crobison/string-art/machine/wiring/guide.html

String art platter machine · wiring

# Set up, test, then wire

Sections A–C set the PiBot V4.96 Pro's jumpers, load the FluidNC config and spin one motor on the bench. Steps 1–5 then show the real parts on a workbench mat with every wire drawn in the colour you will use. Tick each wire off as you go. Your ticks stay in this browser. Hover or tap a wire in the list to light it up in the drawing.

### Before you start

- Tools: small flat screwdriver, wire stripper, multimeter with a continuity beeper, ferrule crimper, soldering iron (step 5 only).
- Wire: 18 AWG red and black for power, 22 AWG for signals. Ferrules to suit both.
- Two Wago 221-415 lever nuts. One is the +24 V bus, one is the GND bus.
- Three JST-XH 2.54 mm 3-pin plugs (or a crimp kit) for the endstop cables. The limit inputs are sockets, not screw terminals.
- A barrel-jack-to-screw adapter rated 10 A that matches the brick's tip. Many are rated 3–5 A. Or cut the brick's plug off and put its leads straight into the lever nuts.

#### Four rules

1. The power brick stays unplugged from the wall while you wire.
2. Never plug or unplug a motor while the power is on. It destroys the driver.
3. Red is always +, black is always GND. Check with the meter before the first power-up.
4. The brick is set to 24.0 V and never higher. The board's main input is rated 9–24 V.

### Reading the drawings

An orange dashed box marks the terminals you touch in that step. The PiBot drawing is simplified, but every connector is on the correct edge of the board. Several of the board's terminals have no pin labels. Where that matters, the step says how to find each pin with the meter.

A

## Board setup: jumpers

Set the PiBot's jumpers for this machine before anything is connected. The circled numbers match PiBot's V4.96 Pro pin definition overview (https://wiki.pibot.com/doku.php?id=pibot_cnc_laser_series:v496_pro:v49pro_diagram_overview:start), so you can find each one on their board photo.

#### Do first

1. Board unpowered, USB unplugged, nothing on any terminal.
2. Screw on the Wi-Fi antenna. Without it there is no Wi-Fi. Plug in the OLED. A TF card is optional.
3. Use tweezers or pliers for the jumpers (the small plastic caps that bridge two pins). Fit or remove each one, then check it against the table again.
4. Most jumper headers here have 3 pins: the jumper joins the middle pin to one side, so the side matters. The table says which.

#### Careful

1. Each of the six driver slots has a StepStick socket: two rows of 8 female header pins that a plug-in driver board pushes into. Your TMC2209s are StepSticks, and they go in the sockets of slots 2 and 3.
2. Slot 1 (X on the silkscreen) is different. The DM542T is an external driver and doesn't plug in. Fit all four of slot 1's routing jumpers (header H4, beside the socket), and leave slot 1's socket empty.
3. Never put a TMC2209 in slot 1. With the routing jumpers in, its 24 V motor outputs land on the board's logic lines. That destroys the driver and the board's chips.
4. The board ships with only three jumpers fitted (VDD, SW-VCC, RLY). Every other jumper in this table is one you add.

# | Jumper | Factory | Set to | Why

⑳ | USB 5V | not fitted | None | Feeds USB 5 V into the board for bench use only. PiBot says it must be off whenever the 24 V supply is connected.
⑫ | VDD, labelled "Driver Logic Signal level" (VDDSEL1) | 3V3 | +5V side | The DM542T's inputs need 5 V signals. TMC2209s run on anything from 3.3 to 5 V, and VDD also sets the high level for MS1/MS2.
⑦ | SW-VCC (SWVSEL1), limit inputs | +5V | +5V (leave) | Correct for plain mechanical switches. The VMOT side is only for 12–24 V NPN sensors.
⑬ | RLY (GPIO26 function), in the header marked SLP RST NULL MS2 MS1 RLY | Relay | Relay (leave) | Lets gpio26 drive the on-board relay that switches the drill (step 5). Note which side it is on: MS1 and MS2 go on the same side.
⑯ ⑰ | Slot 1 routing jumpers (H4), 4 of them | none | All 4 fitted | Sends slot 1's EN, STP, DIR and GND out to its green terminal for the DM542T. This is PiBot's "external standard driver" mode.
⑯ ⑰ | Slot routing jumpers, slots 2–6 | none | None | Slots 2 (Y) and 3 (Z) hold the TMC2209s, which drive their green terminals directly.
⑭ | MS1 and MS2 (one pair shared by all six sockets) | none | Both fitted, same side as RLY | That side is VDD, so MS1 = MS2 = high: the TMC2209's 1/16 microstepping (3200 steps/turn), which the config assumes. On the other side they pull low and the drivers run at 1/8.
⑭ | NULL, RST, SLP | none | None | NULL (the MS3 position) isn't connected on this board. RST and SLP are only for A4988/DRV8825 drivers. An SLP jumper to VDD would hold the TMC2209s' CLK pin high.
⑲ | SPI jumpers | none | None | Only for SPI-mode drivers (TMC2130, TMC5160). Ours run standalone on step/dir.

#### Check before moving on

1. Count the jumpers: 9 on the board in total, whatever the board shipped with. VDD on +5V (1), SW-VCC on +5V (1), RLY on relay (1), slot 1 routing (4), MS1 and MS2 on the same side as RLY (2). Nothing on USB-5V, NULL, RST, SLP, SPI or slots 2–6.
2. If your count isn't 9, compare each row of the table above with the board until it is. Spare jumpers go in a bag, not on unused pins.
3. Optional meter check once the board has 24 V (section B): socket 2's MS1 and MS2 pins read about 5 V to GND. The bench test in section C proves this anyway.

B

## Firmware and config

The board ships with FluidNC 3.9.9 already flashed and a factory test config. You don't need to flash anything. You only upload our two config files.

#### Power the bare board

1. The power inputs are the orange connectors on the board's bottom edge, labelled underneath: Vmot-Driver, Vmot, then MOSFET and RELAY.
2. Wire only the first two pairs of step 1: brick → lever nuts → Vmot (+ and − are printed under it). Vmot is a plug: pull it straight off, wire it, push it back on. Nothing else connected yet.
3. Plug in the brick. The 5 V LED lights and the OLED shows FluidNC.
4. Meter across Vmot-Driver: about 0 V. It's a separate input that only feeds the driver sockets.

#### Not a power input

1. The black 5-pin header near the ESP32 is labelled GP27, GP25, +5V, VMOT Main, GND. It's an output for add-on modules. Never connect the brick there.

#### Open the web interface

1. On a laptop or phone, join Wi-Fi FluidNC, password 12345678.
2. Browse to http://192.168.0.1. That opens FluidNC's WebUI.
3. Optional: PiBot's own 60-minute factory checklist (https://wiki.pibot.com/doku.php?id=pibot_cnc_laser_series:v496_pro:check_list_before_use:start) tests every input and output with the factory config. Run it now if you want a known-good board before you start.

#### Upload our configs

1. From the repo, copy machine/fluidnc-bench.yaml as bench.yaml and machine/fluidnc-config.yaml as stringart.yaml.
2. Upload both to the board's flash, not the SD card: FluidNC only reads its config from flash. The Files panel on the WebUI dashboard shows only the SD card. The flash is under the FluidNC tab at the top of the WebUI: press Manage local files and upload there. Leave the factory config.yaml there as a fallback.
3. In the WebUI console, send these one line at a time:

$Config/Filename=bench.yaml
$Bye                       (restarts the board)
$SS                        (startup log: look for errors)
$CD                        (prints the config it actually loaded)

The startup log should have no [MSG:ERR: lines. $CD should show name: StringArtBench. A config problem leaves the board in alarm, and $X then answers "Configuration is invalid". To go back to the factory test config, send $Config/Filename=config.yaml and $Bye.

#### Only if you ever need to re-flash

1. Use Chrome or Edge, which can open serial ports from a web page. Go to installer.fluidnc.com, plug in USB and pick the port.
2. Choose Install FluidNC, then pick release v3.9.9 to match the factory firmware (the newest 4.x also accepts our configs). Then processor esp32 if asked, firmware variant wifi, installation type fresh-install. In the confirm box, under Extra Options, tick Install WebUI-2, then Install.
3. If it reports "Bootloader not active", hold the board's BOOT button while it connects.
4. Linux: the board's CP2102 USB chip needs no driver, but your user must be in the dialout group (uucp on Arch): sudo usermod -aG dialout $USER, then log out and back in.
5. A fresh install wipes the flash, so upload both YAML files again afterwards.

C

## Bench test: one motor

Before the full wiring, prove one driver, one motor and the config on the bench. Each test command turns the motor shaft exactly once, so it checks the microstep setting as well as the wiring. Uses bench.yaml, which has no homing, so you can jog straight away.

#### Test 0: signal LEDs, no motor

1. Power goes only to the orange plug-in connector labelled Vmot (CN3). Leave the Vmot-Driver screw terminal unconnected, the driver sockets empty and every motor unplugged.
2. Check that the board is running bench.yaml: send $SS. The log should show Configuration file:bench.yaml and no [MSG:ERR: line. If it names a different file, send $Config/Filename=bench.yaml, then $Bye.
3. Find the signal LEDs: each slot has a column of three small LEDs just right of its socket, labelled by the I2S output that drives them, not by name. Slot 1: I2.0 = EN, I2.2 = STEP, I2.1 = DIR. Slot 2: I2.7 = EN, I2.5 = STEP, I2.4 = DIR. Slot 3: I2.8 = EN, I2.10 = STEP, I2.9 = DIR.
4. The EN LEDs (I2.0, I2.7, I2.8) should be off. A lit EN LED means that driver is switched off; off means the config is holding it on.
5. Send $J=G91 X10 F300, then $J=G91 X-10 F300. Slot 1's DIR LED (I2.1) changes state between the two: on for one direction, off for the other. The STEP LED (I2.2) may glow faintly or not visibly at all: the pulses are only 4 µs long. The DIR LED is the reliable check.
6. Repeat with $J=G91 Y10 F600 and $J=G91 Y-10 F600: slot 2's DIR LED (I2.4) changes state. This is PiBot's test 2.8.

#### Test 1: arm motor (small NEMA17) on a TMC2209

1. This test uses one of your two small, thin NEMA17 motors (17HE08-1004S, 1 A). This one will drive the threader arm (Y). It is not the platter: the platter's motor is the big NEMA23, tested in Test 2. Nothing needs to be built yet. The motor just sits on the bench.
2. Brick unplugged. Add the second power pair from step 1: brick + and − to the orange Vmot-Driver screw terminal. This one feeds the driver sockets, and Vmot keeps feeding the board.
3. Plug a TMC2209 into socket 2, the socket next to the I2.7, I2.5 and I2.4 LEDs. Its EN pin goes to the socket's EN mark (step 3's drawing). No motor yet.
4. Power on. Set the TMC2209's current: measure Vref and turn its pot until it reads 0.9–1.0 V (step 3 shows where). It reads 0 V until Vmot-Driver has 24 V.
5. Brick unplugged again. Find the motor's two coils with the meter: black–blue is one, green–red the other, about 3.6 Ω each. Connect it to slot 2's green terminal as in step 3: black and blue on the two screws at one end, green and red on the two at the other. Stick a tape flag on the shaft so you can count turns.
6. Power on. Send $J=G91 Y40 F600: the shaft turns exactly once in about 4 s. Send $J=G91 Y-40 F600: it turns back.

#### Test 2: platter NEMA23 on the DM542T

1. Brick unplugged. Wire step 1's DM542T pair and all of step 2, with the DIP switches set and the DM542T's 5V/24V selector (if it has one) on 5V.
2. Power on. The DM542T's green LED lights, and the red one stays off.
3. Send $J=G91 X72 F600: the NEMA23 shaft turns exactly once in about 7.5 s. (72 nails × 44.444 = 3200 steps.) $J=G91 X-72 F600 brings it back.
4. With the belt and platter fitted, upload and run machine/platter-test.gcode (about 6 min). It runs half turns at rising speeds, full-speed turns and a threading pattern, and stops for 5 s after each part so you can check that a mark on the rim still lines up with a fixed pointer. If it drifts or sounds rough, lower max_rate_mm_per_min or acceleration_mm_per_sec2 on X.

You see | Cause | Fix
Exactly one turn | Everything is right | Move on
Small NEMA17 turns twice | TMC2209 at 1/8: MS1/MS2 jumpers missing or on the wrong side | Both on the same side as RLY (section A)
Small NEMA17 turns ½ or ¼ turn | TMC2209 at 1/32 or 1/64: only one MS jumper is high | Put MS1 and MS2 on the same side as RLY, and re-seat both
NEMA23 turns half a turn | DM542T at 6400 | SW5–8 = ON ON OFF ON
NEMA23 turns twice | DM542T at 1600 (SW5–8 = OFF OFF ON ON) | SW5–8 = ON ON OFF ON
Motor buzzes or jitters but doesn't turn | The two wires of one coil are split across the two coil pairs | Power off. Find the pairs with the meter (small NEMA17 about 3.6 Ω, NEMA23 about 1 Ω between the two wires of a coil) and put each coil on its own pair of screws
Silent, shaft turns freely by hand | No motor power, driver disabled, or no signal reaching it | TMC2209: is 24 V on Vmot-Driver? Is Vref above 0? DM542T: is the green LED on, and is the 5V/24V selector on 5V?
Silent, and the slot's DIR LED doesn't change between + and − jogs | Config problem, or the controller is in alarm | Send $X, then check $SS for [MSG:ERR: lines
DM542T red LED blinks | 1 blink: over-current or a short in the motor wiring. 2 blinks: over-voltage | Power off and check the motor leads and the brick's voltage
Turns the wrong way | Normal: direction is arbitrary until set | Fix it later, after assembly: add :low to that axis's direction_pin

#### When both motors pass

1. Power off and finish wiring with steps 1–5 below.
2. Then switch to the real config: $Config/Filename=stringart.yaml and $Bye. It expects homing, so it starts locked. $H homes once the endstops are in. $X unlocks without homing, but then nail 0 is wherever the platter happens to be.

✓

## First full power-up

Everything is wired. Go through this once before plugging the brick into the wall.

#### Checklist

1. Every motor is plugged in, and stays plugged in while the power is on.
2. No loose copper strands at any screw terminal. Tug every wire.
3. Meter: 24 V on the lever nuts, not more.
4. Jumpers still match section A (9 in total). Slot 1's socket is empty.
5. Both TMC2209s point the right way, Vref set to 0.9–1.0 V.
6. $Config/Filename=stringart.yaml, $Bye, then $SS shows no [MSG:ERR: lines.
7. Send ?. There is no Pn: entry with every switch at rest.
8. Home with $H: Y and Z home first, then X finds nail 0. Keep a hand on the wall plug the first time.
9. Drill test with the bit out: M3 S1000 spins it after the 2 s spin-up wait, M5 stops it. If the board resets when the drill starts, see step 5.

Generated by machine/wiring/make_harness.py from the same wire list as the KiCad schematic (wiring.kicad_sch) and the WireViz diagrams (harness/). Every wire here is checked against the schematic's netlist when the page is built.

Pins, jumpers and the flashing steps follow PiBot's V4.96 Pro wiki (https://wiki.pibot.com/doku.php?id=pibot_cnc_laser_series:v496_pro:introduction:start) and its factory test YAML and schematic, checked 2026-11-05. The config is machine/fluidnc-config.yaml, and the bench config is machine/fluidnc-bench.yaml.
