crobison/string-art/machine/wiring/harness/03_arm_drill_motors.html

# Step 3: threader (Y) and drill-feed (Z) motors

## Diagram

## Bill of Materials

Id | Description | Qty | Unit | Designators
1 | Connector, NEMA17 17HE08-1004S (small, thin), drill feed motor (Z), 4 pins | 1
2 | Connector, NEMA17 17HE08-1004S (small, thin), threader motor (Y), 4 pins | 1
3 | Connector, PiBot V4.96 Pro, slot 2 green terminal (Y, TMC2209 fitted), 4 pins | 1
4 | Connector, PiBot V4.96 Pro, slot 3 green terminal (Z, TMC2209 fitted), 4 pins | 1
5 | Wire, 22 AWG, black | 0 | m | Y motor cable, Z motor cable
6 | Wire, 22 AWG, blue | 0 | m | Y motor cable, Z motor cable
7 | Wire, 22 AWG, green | 0 | m | Y motor cable, Z motor cable
8 | Wire, 22 AWG, red | 0 | m | Y motor cable, Z motor cable
