crobison/string-art/machine/wiring/harness/01_power.html

# Step 1: 24 V power distribution

## Diagram

## Bill of Materials

Id | Description | Qty | Unit | Designators
1 | Connector, 24 V power brick, barrel adapter rated 10 A, or bare leads, 2 pins | 1
2 | Connector, DM542T, power + motor terminal, 6 pins | 1
3 | Connector, PiBot V4.96 Pro, orange power inputs, bottom edge, 4 pins | 1
4 | Connector, Wago 221-415 lever nut, +24 V bus (5-way), 5 pins | 1
5 | Connector, Wago 221-415 lever nut, GND bus (5-way), 5 pins | 1
6 | Wire, 18 AWG, black | 0 | m | DM542T power, PSU leads, PiBot Vmot, PiBot Vmot-Driver
7 | Wire, 18 AWG, red | 0 | m | DM542T power, PSU leads, PiBot Vmot, PiBot Vmot-Driver
