crobison/string-art/machine/wiring/harness/02_platter.html

# Step 2: platter motor (X) on the DM542T

## Diagram

## Bill of Materials

Id | Description | Qty | Unit | Designators
1 | Connector, DM542T, power + motor terminal, 6 pins | 1
2 | Connector, DM542T, signal terminal, 6 pins | 1
3 | Connector, NEMA23 23HS45-4204S, platter motor (X), 4 flying leads, 4 pins | 1
4 | Connector, PiBot V4.96 Pro, slot 1 green terminal (X, routing jumpers in), 4 pins | 1
5 | Wire, 18 AWG, black | 0 | m | NEMA23 leads (18 AWG)
6 | Wire, 18 AWG, blue | 0 | m | NEMA23 leads (18 AWG)
7 | Wire, 18 AWG, green | 0 | m | NEMA23 leads (18 AWG)
8 | Wire, 18 AWG, red | 0 | m | NEMA23 leads (18 AWG)
9 | Wire, 22 AWG, black | 0 | m | X step/dir
10 | Wire, 22 AWG, white | 0 | m | X step/dir
11 | Wire, 22 AWG, yellow | 0 | m | X step/dir
