crobison/string-art/machine/wiring/harness/04_endstops.html

# Step 4: endstops (wired normally-closed)

## Diagram

## Bill of Materials

Id | Description | Qty | Unit | Designators
1 | Connector, Endstop switch, X index: fires at nail 0, 3 pins | 1
2 | Connector, Endstop switch, Y home: tip outside the ring, 3 pins | 1
3 | Connector, Endstop switch, Z home: drill fully up, 3 pins | 1
4 | Connector, PiBot V4.96 Pro, X limit input io33 (3-pin JST-XH), 3 pins | 1
5 | Connector, PiBot V4.96 Pro, Y limit input io32 (3-pin JST-XH), 3 pins | 1
6 | Connector, PiBot V4.96 Pro, Z limit input io35 (3-pin JST-XH), 3 pins | 1
7 | Wire, 22 AWG, black | 0 | m | X endstop, Y endstop, Z endstop
8 | Wire, 22 AWG, white | 0 | m | X endstop, Y endstop, Z endstop
