crobison/string-art/machine/wiring/harness/05_drill_relay.html

# Step 5: drill on the on-board relay

## Diagram

## Bill of Materials

Id | Description | Qty | Unit | Designators
1 | Connector, 1N5822 diode, flyback, solder across the drill tabs, 2 pins | 1
2 | Connector, 555 drill motor, 24 V, solder tabs, 2 pins | 1
3 | Connector, PiBot V4.96 Pro, on-board relay terminal (gpio26), 3 pins | 1
4 | Connector, Wago 221-415 lever nut, +24 V bus (5-way), 5 pins | 1
5 | Connector, Wago 221-415 lever nut, GND bus (5-way), 5 pins | 1
6 | Wire, 18 AWG, black | 0 | m | Drill 24 V (18 AWG)
7 | Wire, 18 AWG, red | 0 | m | Drill 24 V (18 AWG)
8 | Wire, 22 AWG, silver | 0 | m | Diode legs
