crobison/string-art/machine/wiring/wiring.pdf

1 | 2 | 3 | 4 | 5 | 6 | 7 | 8
1 | 2 | 3 | 4 | 5 | 6 | 7 | 8

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
Size: A3 | Rev: 2 | F Date: 2026-11-04
KiCad E.D.A. 10.0.8 | Id: 1/1

## Title: String art machine wiring

File: wiring.kicad_sch

Sheet: /

crobison/string-art

Generated by machine/wiring/make_schematic.py

Pins mirror machine/fluidnc-config.yaml

M

A+/blk
A-/blu
B+/grn

B-/red M2

17HE08-1004S threader (Y)

PUL+
PUL-DIR+
DIR-ENA+
ENA-

VDC
GND

A+
A-B+
B-
U2 CN3 Vmot (main) | DM542T, DIP 1-8: OFF ON OFF OFF ON ON OFF ON
CN4 Vmot-Driver Limit inputs, JST-XH (SW-VCC 5V) CN1 relay (gpio26) | TBX1 slot 1 (jumpers in) Socket 2 (Y) signals Socket 3 (Z) signals Driver logic (VDD jumper 5V) VMAIN+

VMAIN-

VDRV+
VDRV-

X_LIM/gpio33
Y_LIM/gpio32
Z_LIM/gpio35
LIM_GND
SW_VCC

RLY_COM
RLY_NC
RLY_NO

EN/I2SO.0
STP/I2SO.2
DIR/I2SO.1
S1_GND

STEP/I2SO.5
DIR/I2SO.4
EN/I2SO.7

STEP/I2SO.10
DIR/I2SO.9
EN/I2SO.8
VDD MS1 MS2 U1 PiBot V4.96 Pro (ESP32, FluidNC) | M

A+/blk
A-/grn
B+/red

B-/blu M1

23HS45-4204S platter (X)

COM
NCNO

SW3

Z home (drill up) | STEP DIR ENMS1 MS2

VIO
GND

VM
GND

1A 1B

2A 2B U4

TMC2209 in socket 3 (Z), Vref 0.9-1.0 V COM

NCNO

SW2

Y home (tip outside) COM
NCNO

SW1

X index (nail 0) | M

A+/blk
A-/blu
B+/grn

B-/red M3

17HE08-1004S drill Z

+24V GND

J1

24 V 6 A brick + barrel-to-screw adapter | K

AD1

1N5822 flyback (recommended) | STEP DIR ENMS1 MS2

VIO
GND

VM
GND

1A 1B

2A 2B U3

TMC2209 in socket 2 (Y), Vref 0.9-1.0 V + M -

M4

555 drill motor (24 V) | X_A+

X_B-

X_A-

Y_B2

X_B+
X_B-

+24V GND

Y_B1

Z_STEP
Z_DIR
Z_EN
VDD

VDD

X_B+

X_A-

X_A+

+24V | GND X_DIR GND

X_STEP

Y_EN

Y_DIR

Y_STEP

GND

X_DIR

X_STEP

Z_B2 GND +24V

Y_B2

Y_B1

Y_A2

Y_A1 GND

VDD

VDD

VDD

Y_EN

Y_DIR

Y_STEP

VDD
Z_B1

Z_A2

Z_A1

Z_B2

Z_B1

Z_A2

Y_A1

Z_A1

Y_A2 GND +24V GND

+24V DRILL+

DRILL+
GND

Z_STEP

GND

Y_LIM

X_LIM

# GND +24V Z_LIM

GND

DRILL+

+24V GND

X_LIM

Z_LIM

GND

GND
Y_LIM

GND

VDD

GND

Z_DIR

VDD

VDD

Z_EN NOTES

1. Pins follow the PiBot V4.96 Pro factory YAML and schematic (sch496, 2025-10-24), checked 2026-11-05, and ../fluidnc-config.yaml. Steppers are on the I2S shift register (I2SO.n).
2. Jumpers, 9 in total: VDD on 5V, SW-VCC on 5V, RLY (GPIO26) on relay, MS1 + MS2 on the VDD side (1/16), slot 1 routing x4. USB-5V, RST, SLP, NULL, SPI and slots 2-6 routing: none. Slot 1's StepStick socket stays EMPTY: a driver in a jumpered slot destroys it and the board.
3. Power, brick at 24.0 V max: CN3 "Vmot" (orange plug, main) and CN4 "Vmot-Driver" (sockets)
both from the lever nuts, plus the DM542T VDC. "VMOT Main" on header J3 is an OUTPUT.
4. DM542T common cathode: STP to PUL+, DIR to DIR+, GND to PUL- and DIR-, ENA open. 5V/24V selector (V4.0) on 5V. DIP SW1-3 OFF ON OFF (2.36 A RMS), SW4 OFF, SW5-8 ON ON OFF ON (3200).
5. TBX1 has no pin labels. Pin 1-4 with routing jumpers in: EN, STP, DIR, GND.
TBY2/TBZ3 pin 1-4 = 2B, 2A, 1A, 1B: each coil on two neighbouring screws. 6. TMC2209 standalone, 1/16: MS1 = MS2 = HIGH. Vref 0.9-1.0 V, max 1.4 V (needs CN4 powered).
7. Endstops COM to GND, NC to Signal: closed at rest, opens when hit or if a wire breaks;
config pins have no :low. Input LEDs are lit at rest and go out when a switch is pressed.
8. Relay CN1: pin 1 COM, pin 2 NC (unused), pin 3 NO. D1 across the drill, stripe to +. 9. Small NEMA17 17HE08-1004S coils: black/blue = A, green/red = B. NEMA23: black/green, red/blue.
