crobison/string-art/machine/wiring/harness/01_power.png

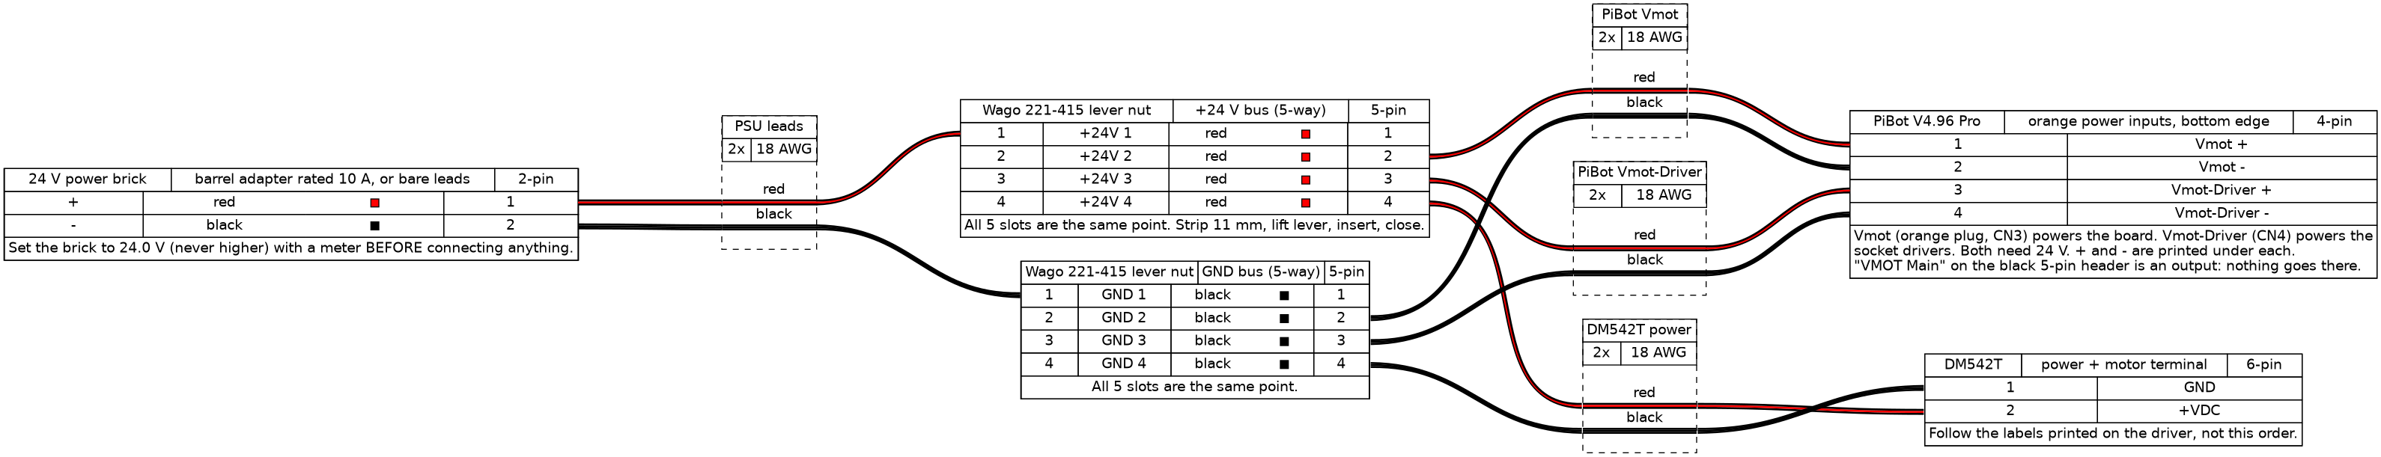
machine/wiring/harness/01_power.png
