crobison/string-art/machine/wiring/harness/02_platter.png

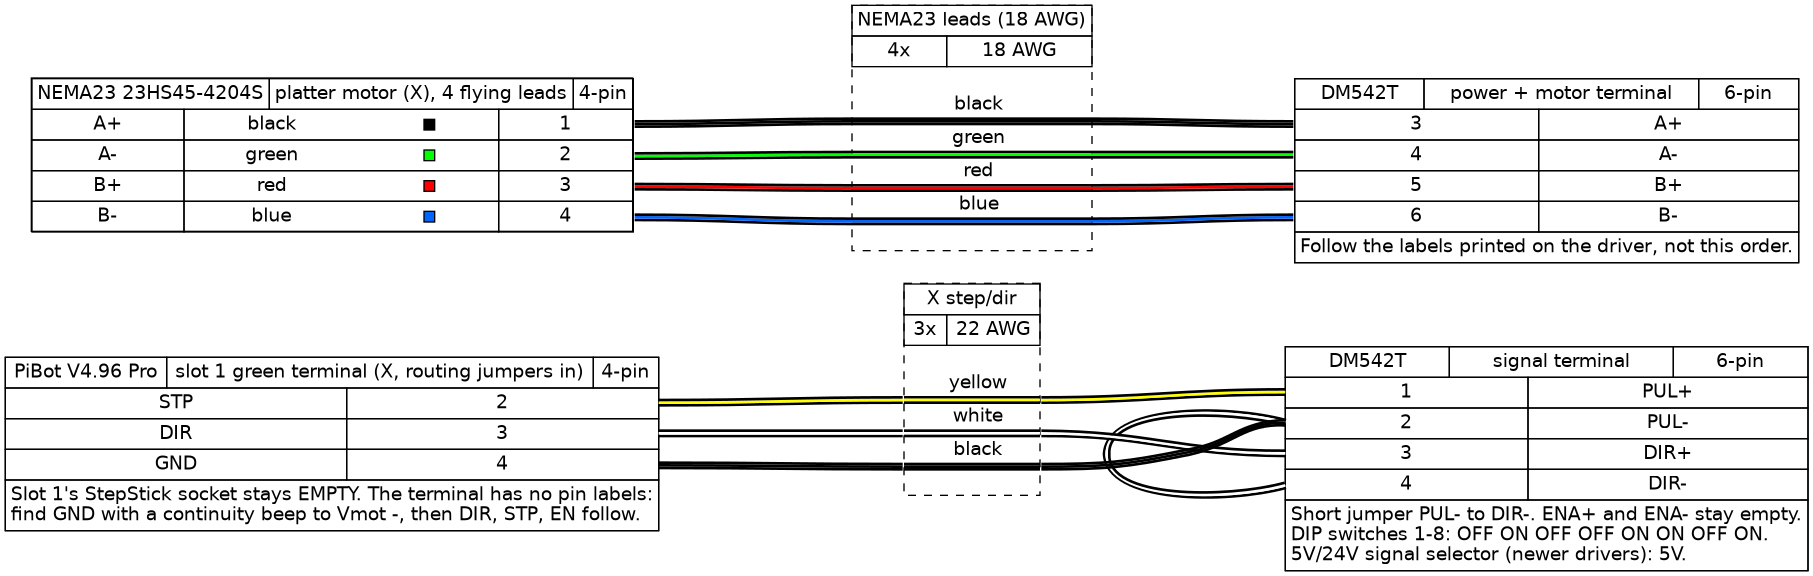
machine/wiring/harness/02_platter.png
