crobison/string-art/machine/wiring/harness/03_arm_drill_motors.png

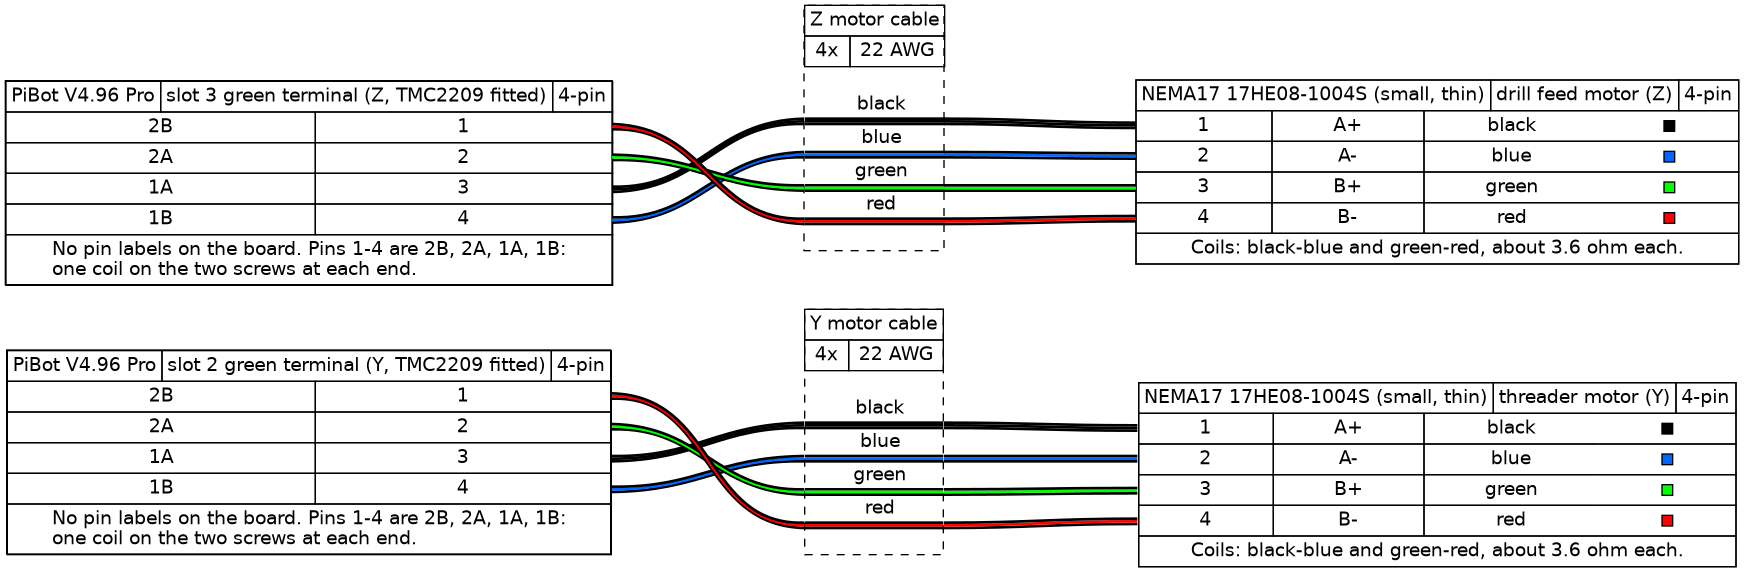
machine/wiring/harness/03_arm_drill_motors.png
