crobison/string-art/machine/wiring/harness/04_endstops.png

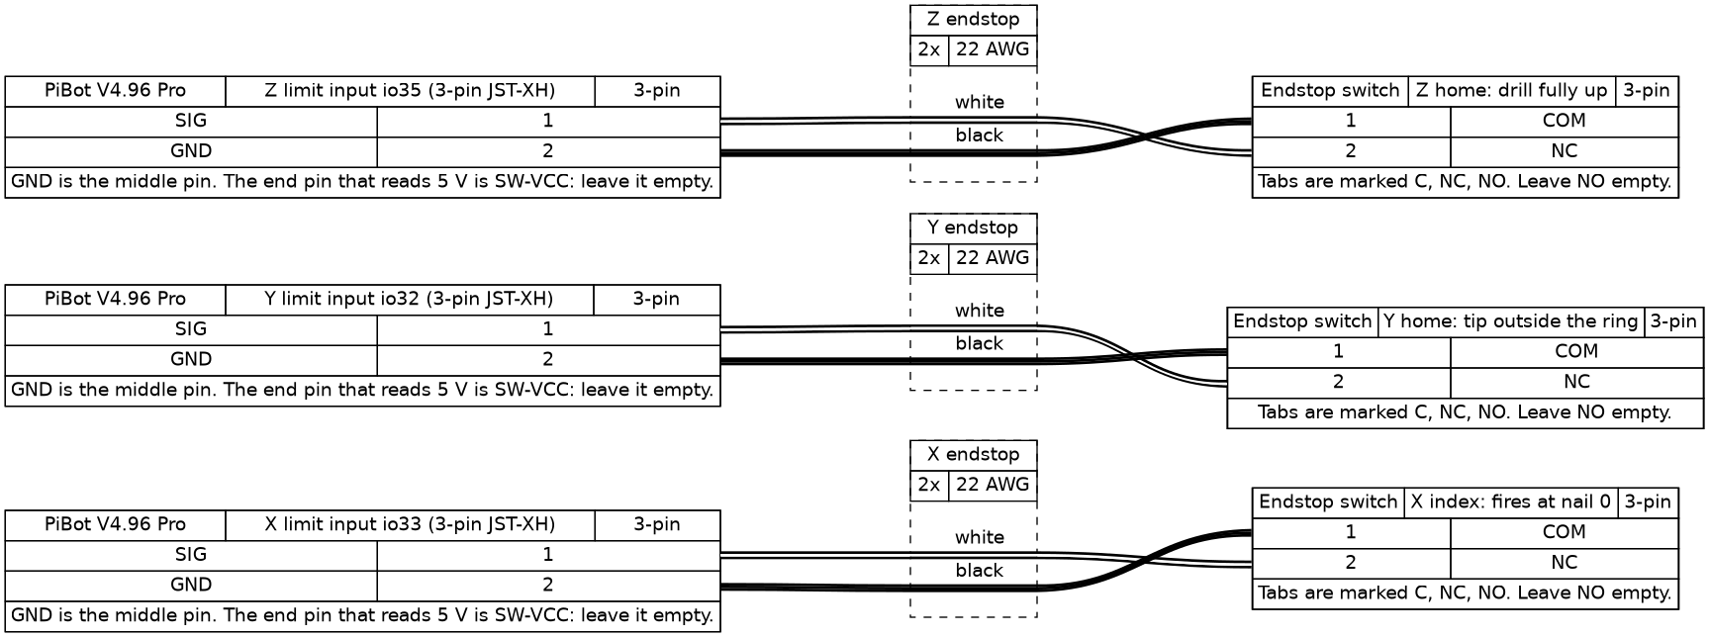
machine/wiring/harness/04_endstops.png
