crobison/string-art/machine/wiring/harness/05_drill_relay.png

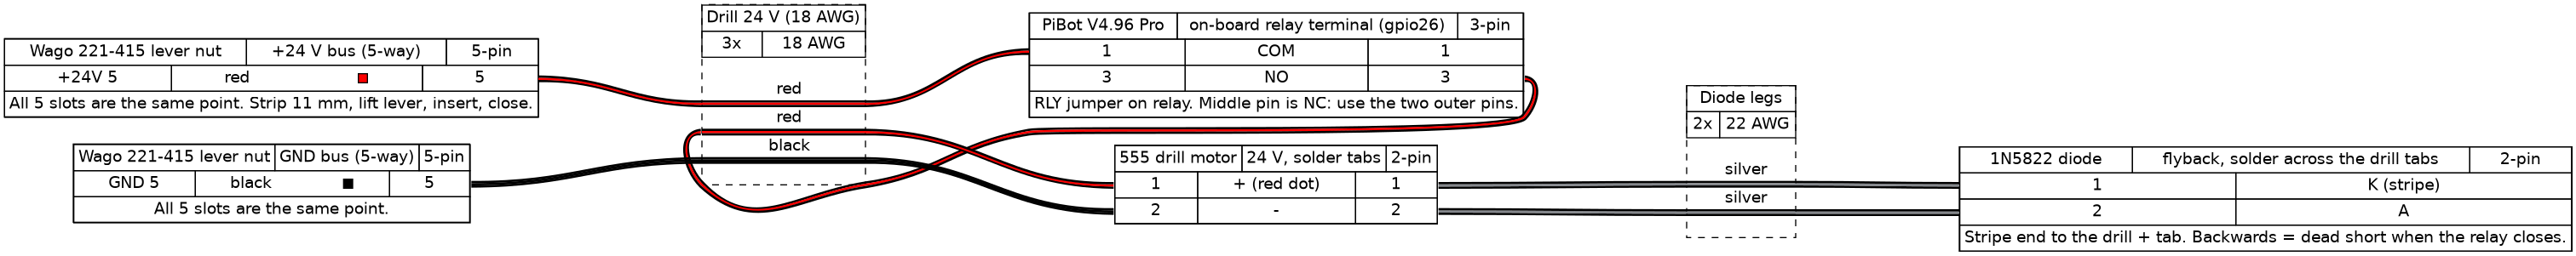
machine/wiring/harness/05_drill_relay.png
