crobison/string-art/machine/wiring/wiring.kicad_sch

## KiCad design machine/wiring/wiring.kicad_sch (2026-11-08)

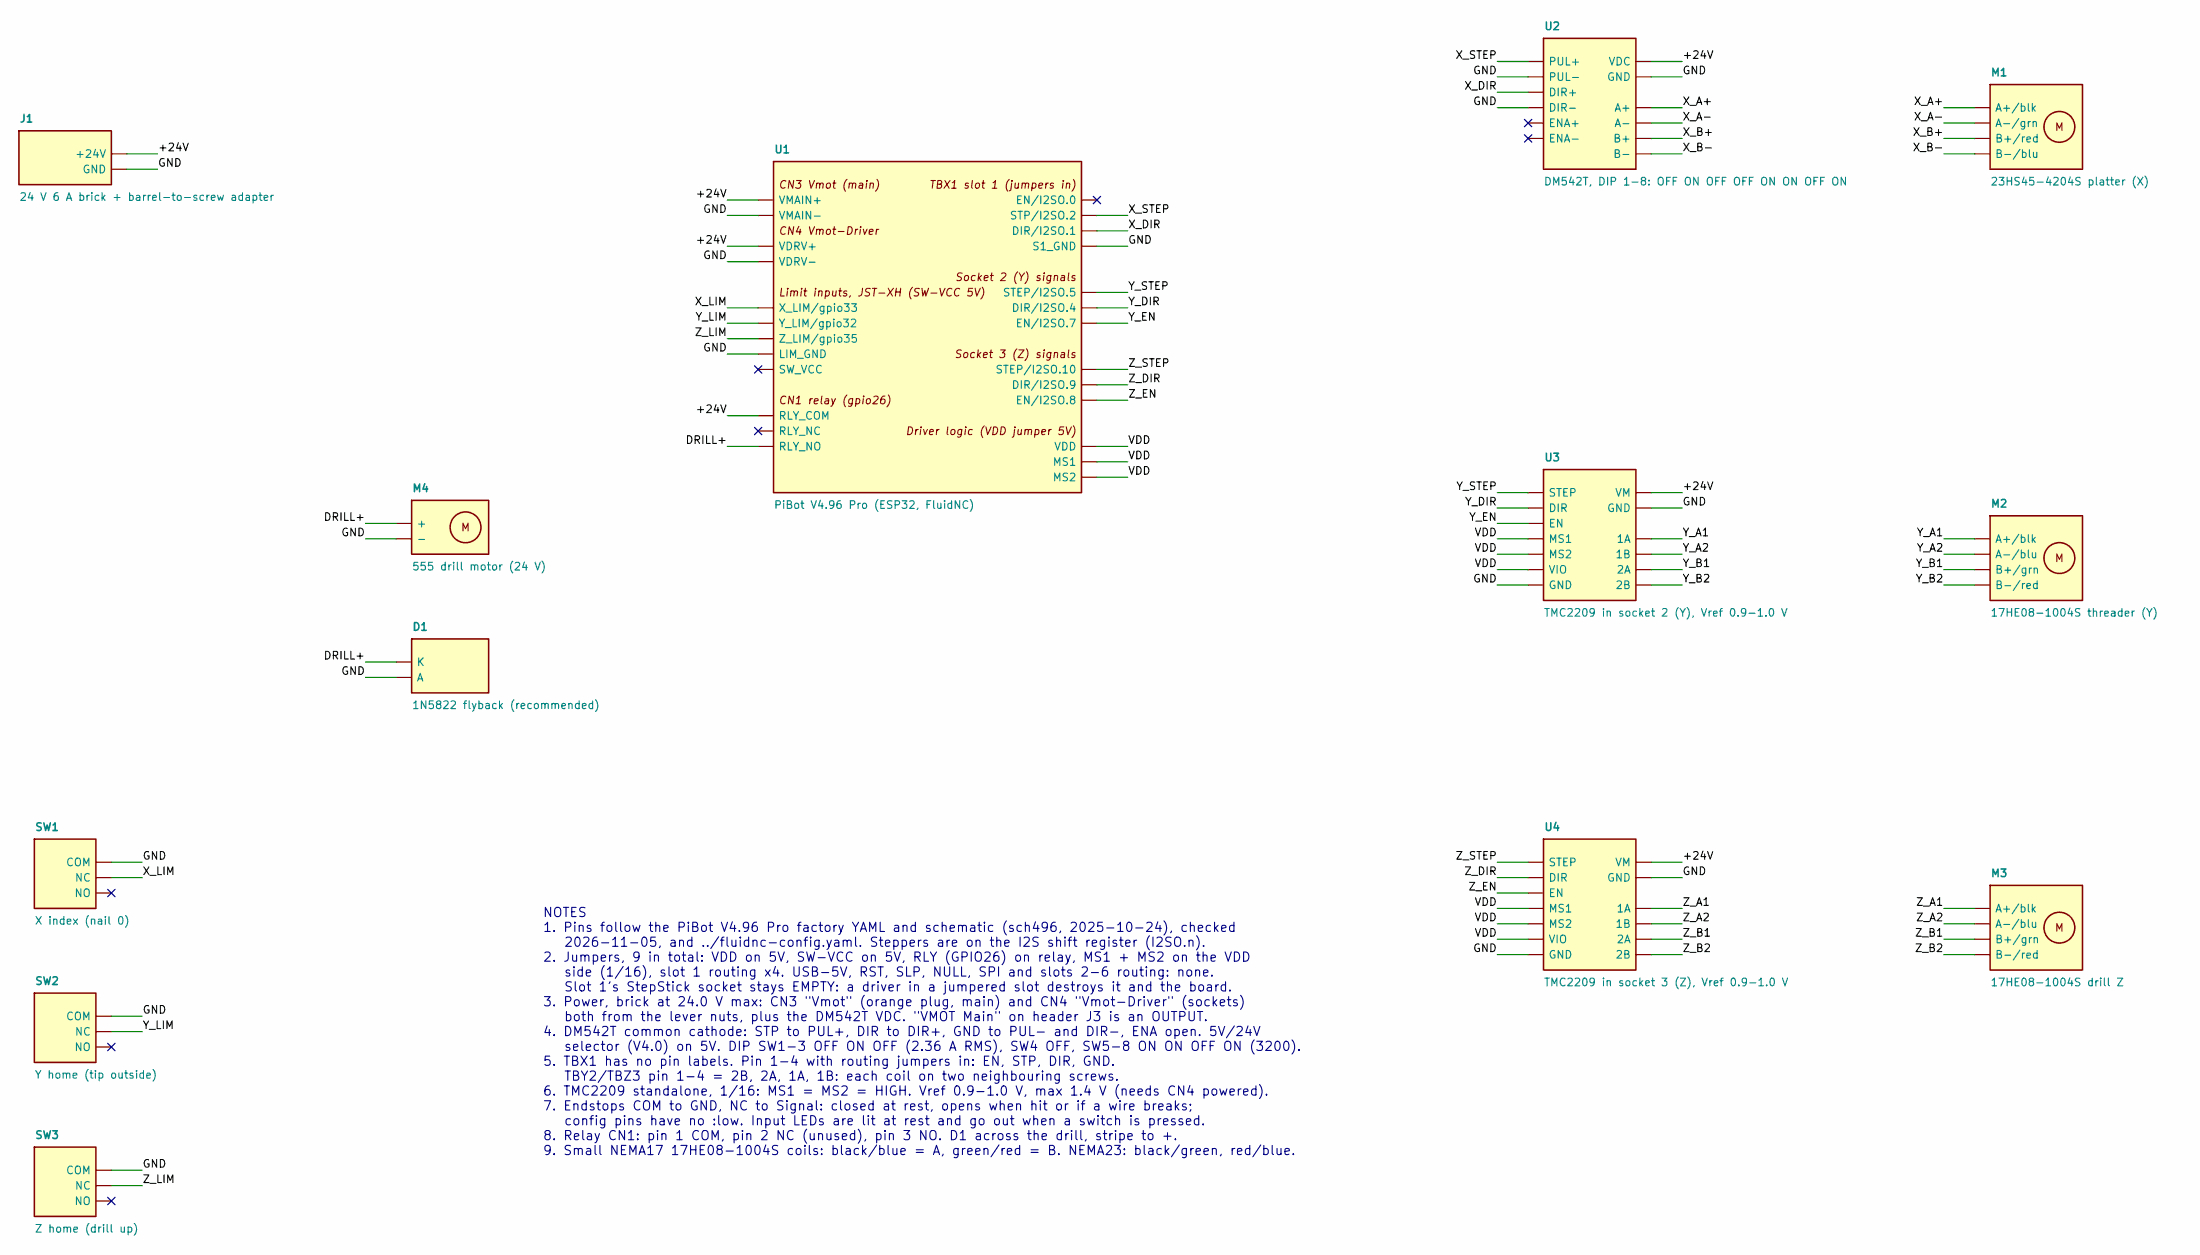
[picture p6: schematic wiring.kicad_sch]

Parts:
D1: 1N5822 flyback (recommended)
J1: 24 V 6 A brick + barrel-to-screw adapter
M1: 23HS45-4204S platter (X)
M2: 17HE08-1004S threader (Y)
M3: 17HE08-1004S drill Z
M4: 555 drill motor (24 V)
SW1: X index (nail 0)
SW2: Y home (tip outside)
SW3: Z home (drill up)
U1: PiBot V4.96 Pro (ESP32, FluidNC)
U2: DM542T, DIP 1-8: OFF ON OFF OFF ON ON OFF ON
U3: TMC2209 in socket 2 (Y), Vref 0.9-1.0 V
U4: TMC2209 in socket 3 (Z), Vref 0.9-1.0 V

Connections:
+24V: J1.1 (+24V), U1.1 (VMAIN+), U1.3 (VDRV+), U1.10 (RLY_COM), U2.7 (VDC), U3.8 (VM), U4.8 (VM)
DRILL+: D1.1 (K), M4.1 (+), U1.12 (RLY_NO)
GND: D1.2 (A), J1.2 (GND), M4.2 (-), SW1.1 (COM), SW2.1 (COM), SW3.1 (COM), U1.2 (VMAIN-), U1.4 (VDRV-), U1.8 (LIM_GND), U1.16 (S1_GND), U2.2 (PUL-), U2.4 (DIR-), U2.8 (GND), U3.7 (GND), U3.9 (GND), U4.7 (GND), U4.9 (GND)
VDD: U1.23 (VDD), U1.24 (MS1), U1.25 (MS2), U3.4 (MS1), U3.5 (MS2), U3.6 (VIO), U4.4 (MS1), U4.5 (MS2), U4.6 (VIO)
X_A+: M1.1 (A+/blk), U2.9 (A+)
X_A-: M1.2 (A-/grn), U2.10 (A-)
X_B+: M1.3 (B+/red), U2.11 (B+)
X_B-: M1.4 (B-/blu), U2.12 (B-)
X_DIR: U1.15 (DIR/I2SO.1), U2.3 (DIR+)
X_LIM: SW1.2 (NC), U1.5 (X_LIM/gpio33)
X_STEP: U1.14 (STP/I2SO.2), U2.1 (PUL+)
Y_A1: M2.1 (A+/blk), U3.10 (1A)
Y_A2: M2.2 (A-/blu), U3.11 (1B)
Y_B1: M2.3 (B+/grn), U3.12 (2A)
Y_B2: M2.4 (B-/red), U3.13 (2B)
Y_DIR: U1.18 (DIR/I2SO.4), U3.2 (DIR)
Y_EN: U1.19 (EN/I2SO.7), U3.3 (EN)
Y_LIM: SW2.2 (NC), U1.6 (Y_LIM/gpio32)
Y_STEP: U1.17 (STEP/I2SO.5), U3.1 (STEP)
Z_A1: M3.1 (A+/blk), U4.10 (1A)
Z_A2: M3.2 (A-/blu), U4.11 (1B)
Z_B1: M3.3 (B+/grn), U4.12 (2A)
Z_B2: M3.4 (B-/red), U4.13 (2B)
Z_DIR: U1.21 (DIR/I2SO.9), U4.2 (DIR)
Z_EN: U1.22 (EN/I2SO.8), U4.3 (EN)
Z_LIM: SW3.2 (NC), U1.7 (Z_LIM/gpio35)
Z_STEP: U1.20 (STEP/I2SO.10), U4.1 (STEP)

Notes on the sheet:
NOTES 1. Pins follow the PiBot V4.96 Pro factory YAML and schematic (sch496, 2025-10-24), checked 2026-11-05, and ../fluidnc-config.yaml. Steppers are on the I2S shift register (I2SO.n). 2. Jumpers, 9 in total: VDD on 5V, SW-VCC on 5V, RLY (GPIO26) on relay, MS1 + MS2 on the VDD side (1/16), slot 1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
