crobison/string-art/machine/fluidnc-config.yaml

# FluidNC config for the rotating-platter string art machine on a PiBot V4.96 Pro.
# Upload to the board's flash as stringart.yaml, then  $Config/Filename=stringart.yaml  and restart.
# For the first motor test use fluidnc-bench.yaml instead (no homing, no soft limits).
#
# Pins follow the PiBot V4.96 Pro factory test YAML and wiki (checked 2026-11-04):
#   https://wiki.pibot.com/doku.php?id=pibot_cnc_laser_series:v496_pro:docs:xyzabc-drv8825-config
#   Steppers come out of an I2S shift register (I2SO.n), not plain gpios. I2SO.6 and I2SO.11 drive
#   the MS3 position of sockets 2 and 3 (PDN_UART on a TMC2209): left low, never reuse them.
#   Slot 1 (X)  STEP I2SO.2  DIR I2SO.1  EN I2SO.0   limit gpio.33
#   Slot 2 (Y)  STEP I2SO.5  DIR I2SO.4  EN I2SO.7   limit gpio.32
#   Slot 3 (Z)  STEP I2SO.10 DIR I2SO.9  EN I2SO.8   limit gpio.35
#   On-board relay gpio.26 (GPIO26 function jumper on "Relay Output").  gpio.2 is the probe INPUT.
#
# Board jumpers for this config (see the wiring guide, "Board setup"):
#   9 jumpers: VDD on +5V, SW-VCC on +5V, RLY (GPIO26) on relay, slot 1 routing x4 with its
#   StepStick socket EMPTY, MS1 and MS2 on the VDD side (same side as RLY: 1/16 for the TMC2209s).
#   None on USB-5V, NULL, RST, SLP, SPI or the routing headers of slots 2-6.
#
# Axes:
#   X = platter rotation, in NAIL UNITS.  steps_per_mm is really steps per nail.
#       steps_per_nail = 3200 * gear_ratio / nails      (DM542T at 3200 pulses/rev)
#         4:1 belt, 288 nails -> 44.444    4:1 belt, 256 nails -> 50.0    direct, 288 -> 11.111
#       This is the ONLY value that changes when you change the nail count.
#       Soft limits are off on X so post.py can emit unwrapped coordinates.
#   Y = radial threader slide, mm. Y=0 homed with the tip OUTSIDE the ring, Y=35 tip inside.
#   Z = drill feed, mm. Only used by the drilling program.

board: PiBot V4.96 Pro
name: StringArt
meta: rotating platter (X, nail units) + radial threader (Y) + drill feed (Z)

stepping:
  engine: I2S_STREAM
  # 255 = never disable: keeps the platter energised between moves
  idle_ms: 255
  # DM542T needs >= 2.5 us
  pulse_us: 4
  # DM542T wants DIR settled >= 5 us before the step edge; margin for the I2S engine
  dir_delay_us: 8
  disable_delay_us: 0

axes:
  shared_stepper_disable_pin: NO_PIN

  # ---- Platter: 23HS45-4204S NEMA23 on a DM542T, wired to slot 1's green terminal (EN STP DIR GND).
  #  DM542T DIP (StepperOnline table, 1.8 deg motor):
  #    SW1 OFF  SW2 ON  SW3 OFF -> 3.31 A peak / 2.36 A RMS
  #    SW4 OFF                  -> half current at standstill
  #    SW5 ON   SW6 ON  SW7 OFF  SW8 ON -> 3200 pulses/rev
  #  Newer DM542T (V4.0) have a 5V/24V signal selector, factory 24V: set it to 5V or nothing moves.
  #  Slot 1's terminal has no pin labels: pin 1-4 = EN, STP, DIR, GND (GND beeps to Vmot -).
  #  Signals (common cathode, the PiBot terminal sources 5 V):
  #    STP -> PUL+, DIR -> DIR+, GND -> PUL- and DIR-.  ENA+/ENA- unconnected (always enabled).
  x:
    # steps PER NAIL: 3200 * 4 / 288 (keep the digits: X never wraps)
    steps_per_mm: 44.44444
    # Speed and ramp, in nails (288 per platter turn). Chosen gentle on purpose: the platter is
    # heavy and accuracy matters more than run time. FluidNC ramps at constant acceleration
    # (no S-curve), so the acceleration value IS the smoothness: lower = softer starts and stops.
    #   1500 nails/min = 25 nails/s = 5.2 platter rpm (21 rpm at the motor)
    #   25 nails/s^2   = 1.0 s to reach full speed over 12.5 nails; rim (R 290) at 0.16 m/s^2
    #   half turn 6.8 s, average jump 3.9 s, 1-nail sweep 0.4 s, ~6.4 h for 4000 lines
    #   Motor needs ~0.04 N.m of its 2.4 N.m to do this even with a 7 kg platter: no lost steps.
    #   Check it with platter-test.gcode before raising either number; raise in small steps.
    # nails per minute
    max_rate_mm_per_min: 1500
    # nails per second squared
    acceleration_mm_per_sec2: 25
    # effectively unlimited: X unwraps as the platter turns
    max_travel_mm: 100000
    soft_limits: false
    homing:
      cycle: 2
      positive_direction: false
      mpos_mm: 0
      feed_mm_per_min: 100
      seek_mm_per_min: 400
      settle_ms: 250
      seek_scaler: 1.1
      feed_scaler: 1.1
    motor0:
      # X limit (JST-XH io33): index switch at nail 0, wired NC (no :low)
      limit_neg_pin: gpio.33
      hard_limits: false
      # nail units: X=0 sits 0.4 nail past the switch trip point
      pulloff_mm: 0.4
      standard_stepper:
        step_pin: I2SO.2
        # wrong way round? use I2SO.1:low
        direction_pin: I2SO.1
        # not wired to the DM542T; drives the slot's EN LED only
        disable_pin: I2SO.0

  # ---- Threader: 17HE08-1004S small NEMA17 on a TMC2209 in socket 2, standalone step/dir.
  #  Vref 0.9-1.0 V (~0.65-0.7 A RMS), needs 24 V on Vmot-Driver to read. MS1+MS2 jumpers on the
  #  VDD side = 1/16.  No ms3_pin: that socket position is PDN_UART (I2SO.6 / I2SO.11); low keeps
  #  standalone mode with automatic current reduction at standstill.
  #  Coils on the 17HE08-1004S: black/blue and green/red, each on two neighbouring terminal screws.
  y:
    # GT2 20T pulley (40 mm/rev) at 16 microsteps: 3200 / 40
    steps_per_mm: 80
    max_rate_mm_per_min: 4000
    acceleration_mm_per_sec2: 300
    max_travel_mm: 42
    soft_limits: true
    homing:
      cycle: 1
      # home toward the OUTSIDE end, away from the nails
      positive_direction: false
      mpos_mm: 0
      feed_mm_per_min: 200
      seek_mm_per_min: 1000
      settle_ms: 250
      seek_scaler: 1.1
      feed_scaler: 1.1
    motor0:
      # Y limit (JST-XH io32), wired NC. Normally-open module? add :low
      limit_neg_pin: gpio.32
      hard_limits: false
      pulloff_mm: 1.0
      stepstick:
        step_pin: I2SO.5
        direction_pin: I2SO.4
        disable_pin: I2SO.7

  # ---- Drill feed: 17HE08-1004S on a TMC2209 in socket 3, T8 lead screw. Homes UP to Z=0, so
  #  machine Z runs 0 down to -max_travel; post.py --drill sets work Z0 at the board surface.
  #  400 steps/mm assumes an 8 mm lead (T8x8). A T8x2 screw needs 1600.
  z:
    # 8 mm lead at 16 microsteps: 3200 / 8
    steps_per_mm: 400
    max_rate_mm_per_min: 1500
    acceleration_mm_per_sec2: 100
    max_travel_mm: 30
    soft_limits: true
    homing:
      cycle: 1
      positive_direction: true
      mpos_mm: 0
      feed_mm_per_min: 200
      seek_mm_per_min: 800
      settle_ms: 250
      seek_scaler: 1.1
      feed_scaler: 1.1
    motor0:
      # Z limit (JST-XH io35), wired NC. Normally-open module? add :low
      limit_pos_pin: gpio.35
      hard_limits: false
      pulloff_mm: 1.0
      stepstick:
        step_pin: I2SO.10
        direction_pin: I2SO.9
        disable_pin: I2SO.8

i2so:
  bck_pin: gpio.22
  data_pin: gpio.21
  ws_pin: gpio.17
  # 4 us I2S frames: longer DIR-before-STEP lead for the DM542T
  min_pulse_us: 4

spi:
  miso_pin: gpio.19
  mosi_pin: gpio.23
  sck_pin: gpio.18

sdcard:
  card_detect_pin: NO_PIN
  cs_pin: gpio.5

i2c0:
  sda_pin: gpio.27
  scl_pin: gpio.25

oled:
  i2c_num: 0
  i2c_address: 60
  width: 128
  height: 64
  radio_delay_ms: 1000

# Drill on/off through the PiBot's on-board relay (M3 on, M5 off). Contacts switch the drill's 24 V.
relay:
  direction_pin: NO_PIN
  output_pin: gpio.26
  enable_pin: NO_PIN
  disable_with_s0: false
  s0_with_disable: true
  spinup_ms: 2000
  spindown_ms: 1000
  tool_num: 0
  off_on_alarm: true

start:
  must_home: true
