crobison/string-art/(commit log)

2026-09-29 Bootstrap string art portrait pipeline: research, generator, G-code post
    - docs/RESOURCES.md: recovered algorithms, repos, papers, videos, machine builds
    - generator/stringart.py: photo -> nail sequence (greedy, configurable nail count)
    - machine/post.py: sequence JSON -> FluidNC G-code for a rotating-platter machine
    - machine/fluidnc-config.yaml, machine/DESIGN.md: controller template and BOM
    [fluidnc-config.yaml]
2026-09-30 Machine config: PiBot V4.96 Pro, NEMA23 on DM542T, pancake NEMA17s on TMC2209
    - fluidnc-config.yaml: X as external standard_stepper for the DM542T with DIP
    settings, wiring and steps-per-nail (3200 * 4 / 288); Y/Z Vref and jumper
    notes for the 17HE08-1004S motors
    - DESIGN.md: BOM updated for parts on hand and the chosen controller and PSU
    [fluidnc-config.yaml]
2026-09-30 BOM: endstop, drill and relay picks; LM2596 rails; drill runs from 24 V
2026-09-30 BOM: mark ordered parts, adjustable 24 V PSU, purchase status and remaining list
2026-09-30 Platter, tower and threader mechanical design with dimensioned diagrams
    - machine/PLATTER.md: fixed-shaft hub on two 6001 bearings, 4:1 belt drive,
    swappable dowel-located heads, radial-only threader with a passive cam
    ramp, wrap sequence, thread layering, accuracy budget, build order
    - machine/diagrams/make_diagrams.py + 5 SVG figures generated from one DIMS dict
    - post.py: fix inverted Y naming (Y=0 tip outside the ring, Y=35 inside);
    emitted moves unchanged
    - fluidnc-config.yaml, DESIGN.md: Y travel/homing notes and wrap description
    [fluidnc-config.yaml]
2026-11-04 Wiring for the PiBot V4.96 Pro: schematic, harness, guide, bench config
    Pins, jumpers and flashing steps now follow the PiBot V4.96 Pro wiki and
    factory YAML instead of the generic template:
    - Steppers on the I2S shift register (I2SO.n), engine I2S_STREAM.
    - DM542T on slot 1's green terminal (routing jumpers in, socket empty),
    common cathode: STP->PUL+, DIR->DIR+, GND->PUL-/DIR-.
    - DM542T 3200 pulses/rev is SW5-8 ON ON OFF ON (was 1600 by mistake).
    - 24 V to both Vmot-main and Vmot-driver.
    - Limits on gpio33/32/35, wired NC.
    - Drill on the on-board relay (gpio26); gpio2 is the probe input.
    HiLetgo relay and LM2596 become spares.
    Adds make_schematic.py (KiCad schematic, ERC clean), make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
2026-11-06 Guide: explain StepStick sockets, add total jumper count to board setup
    Reword the board-setup Careful box so it explains what a StepStick socket
    is, which slots get TMC2209s, and why slot 1 stays empty with its four
    routing jumpers fitted. Add a total jumper count (9) with a breakdown to
    "Check before moving on", so a board that shipped with missing jumpers
    can still be verified.
2026-11-06 Guide: say "jumpers" instead of "caps" throughout
    Use one term for the board's jumper caps so the board-setup steps,
    troubleshooting table and final checklist read consistently. The first
    mention explains that a jumper is the small plastic cap bridging two pins.
2026-11-06 Wiring guide, configs and drill G-code: fixes from a full hardware review
    Checked against PiBot's V4.96 Pro schematic, photos of the actual board,
    the DM542T/TMC2209/motor/relay datasheets and FluidNC v3.9.9 source.
    Guide and harness:
    - Power goes to the orange Vmot plug (CN3) and Vmot-Driver (CN4) on the
    board's bottom edge; warn that "VMOT Main" on header J3 is an output.
    - Board drawing redrawn with each connector on its real edge: orange
    power/MOSFET/relay row, teal JST-XH limit inputs (io33/io32/io35).
    - 17HE08-1004S coils are black/blue and green/red (was black/green).
    - Slot terminals have no pin labels: find slot 1's GND by continuity;
    Y/Z pins run 2B 2A 1A 1B, one coil per ne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
2026-11-07 Platter: gentler X speed and ramp, add platter-test.gcode
    X max rate 2000 -> 1500 nails/min and acceleration 30 -> 25 nails/s^2
    (about a 1 s ramp) in both FluidNC configs, to spare the belt, hub and
    thread on a heavy platter. New platter-test.gcode runs a speed ladder,
    full-speed turns, a threading pattern and a repeatability check, each
    returning to the start mark. Guide test 2 points to it; run-time figures
    in PLATTER.md and DESIGN.md updated.
2026-11-08 Guide: clearer Test 0, slot LEDs by their real I2.x labels
    Test 0 now says power goes only to the orange Vmot connector, checks
    $SS for bench.yaml, names each slot's LEDs by the board's silkscreen
    (slot 1: I2.0 EN, I2.2 STEP, I2.1 DIR; slot 2: I2.7/I2.5/I2.4; slot 3:
    I2.8/I2.10/I2.9) and uses the DIR LED, not the faint STEP LED, as the
    check.
2026-11-08 Guide: rewrite Test 1, call the 17HE08 motors small NEMA17s, not pancakes
    "Pancake" read as the platter. Test 1 now says which motor it uses (the
    small 17HE08-1004S for the threader arm, not the platter's NEMA23), where
    Vmot-Driver and socket 2 are, and what each step does. Same wording in the
    guide, harness, schematic note and config comments; schematic and PDF
    regenerated, ERC clean.
